shuuryou/emac/pinout/pinout_blindmate.png

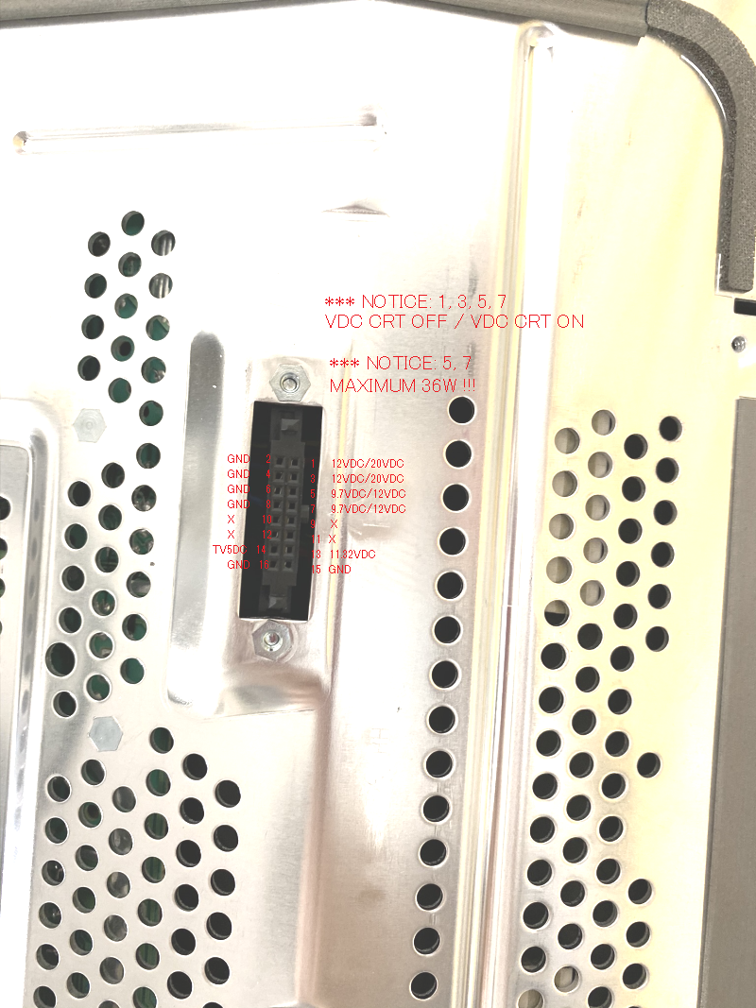
pinout/pinout_blindmate.png
