shuuryou/emac/pinout/pinout_ivad.png

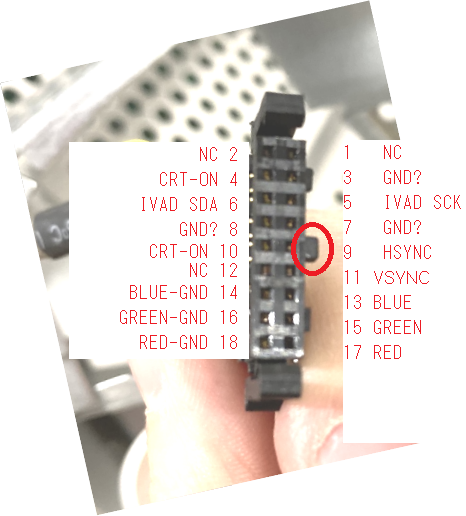
pinout/pinout_ivad.png
