shuuryou/emac/(commit log)

2020-05-21 Create emacedid.bin
    This is the eMac CRT's EDID as extracted from the Open Firmware device tree. It is invalid.
2020-05-30 Add note on IVAD power draw for CRT-ON pins.
